carcon999/ABXY-buttons/README.md

# ABXY-buttons

🌐 Select Language / 言語を選択してください

- 🇯🇵 [日本語 (Japanese)](README.ja.md)
- 🇺🇸 [English](README.en.md)

Watch the video (https://www.youtube.com/watch?v=ZZdw2gTKmag)
