carcon999/ABXY-buttons/document/MY_DEVELOPMENT_ENVIRONMENT.en.md

## Personal Development Environment

This section outlines the development environment I used for this project.  
I am grateful for the many free tools that made this possible.

- Windows 11 Pro
- Arduino IDE 2.3.6
- KiCad Version 9.0.3
- FreeCAD 1.0.1
- Bambu Lab A1 mini (3D printer)

[Back](../README.en.md)
