carcon999/ABXY-buttons/document/MY_DEVELOPMENT_ENVIRONMENT.ja.md

## 個人開発環境
私がこのプロジェクトで使った開発環境の情報を示します。多くの無償で利用できるツールを提供してもらえたことに感謝しています。

- Widows11 Pro
- Arduino IDE 2.3.6
- KiCad Version 9.0.3
- FreeCAD 1.0.1
- Bambu Lab A1 mini (3D Printer)

[戻る](../README.ja.md)
