carcon999/ABXY-buttons/document/Q_AND_A.ja.md

## ノウハウ
問題が発生した場合の解決方法などを整理しておきます。

### ■接続・切断が繰り返される（赤・緑が交互に点滅する）
ペアリングした相手との接続情報が一方で失われて、不一致な状態が発生していると思われます。Windows/Mac/iPhone/Android側で登録されているデバイスを一度削除し、再度ペアリングを実施してみてください。

### ■ボタンを押してもLEDが赤に点灯しない。
久しぶりのご利用の場合は、電池が充電されてない可能性があるので、5分程度充電して反応を確認してください。
電池に残量がある場合には、一度カバーを開けて、Resetボタンを押して（ON->OFF）ください。

### ■シリアルポートが認識されない。
Bootボタンを押しながらResetボタンを押して（ON->OFF）ください。BootLoaderモードで起動することで、必ずシリアルポートが有効になります。

### ■特定のA,B,X,Yボタンが押しても反応しない。
ほこりやゴミが導電ゴムに付着している可能性があります。一度分解して接点部分を掃除してみてください。

### ■シリアルポートが認識されない。（その２）
別なType-Cケーブルでお試しください。充電用ではない、通信が可能なケーブルでもう一度お試しください。

[戻る](../README.ja.md)
