carcon999/ABXY-buttons/hardware/boaud_image.png

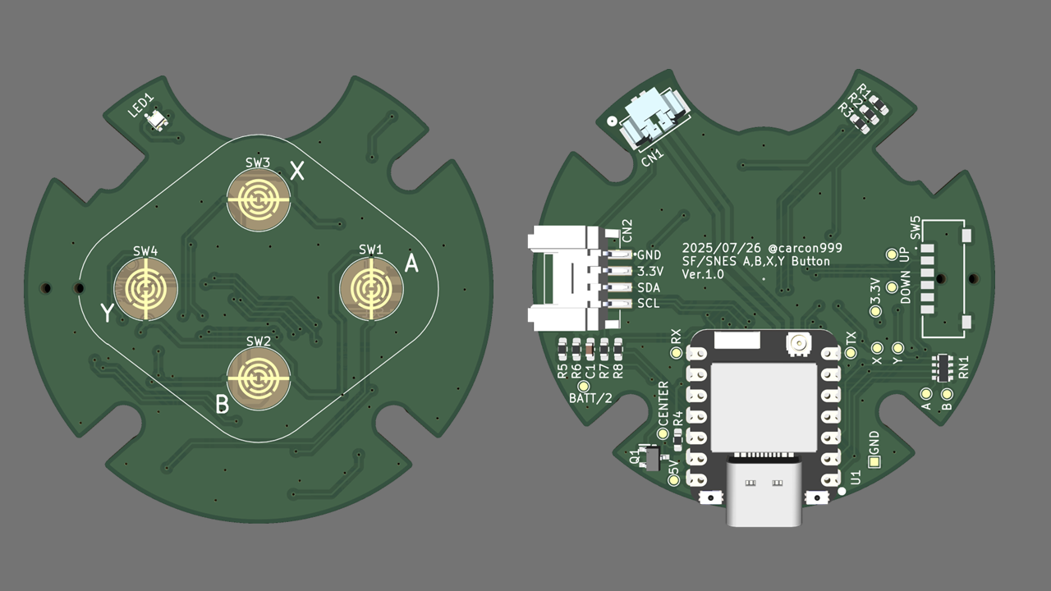
hardware/boaud_image.png
