carcon999/ABXY-buttons/image/change_image.png

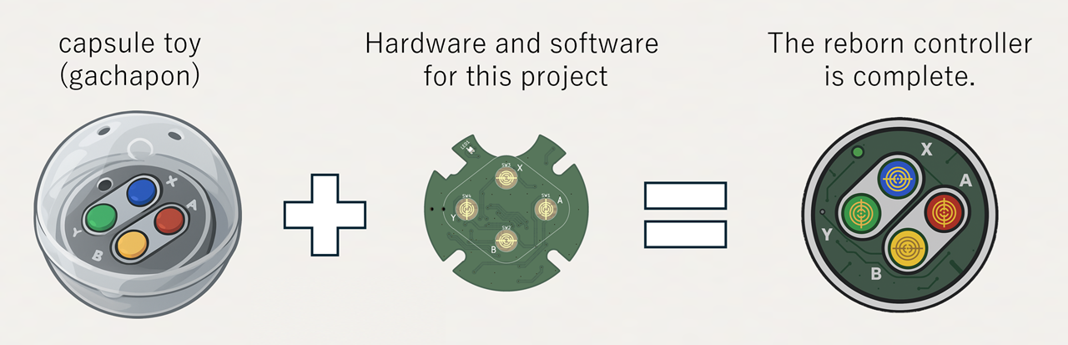
image/change_image.png
