carcon999/ABXY-buttons/image/IMG_1977.jpg

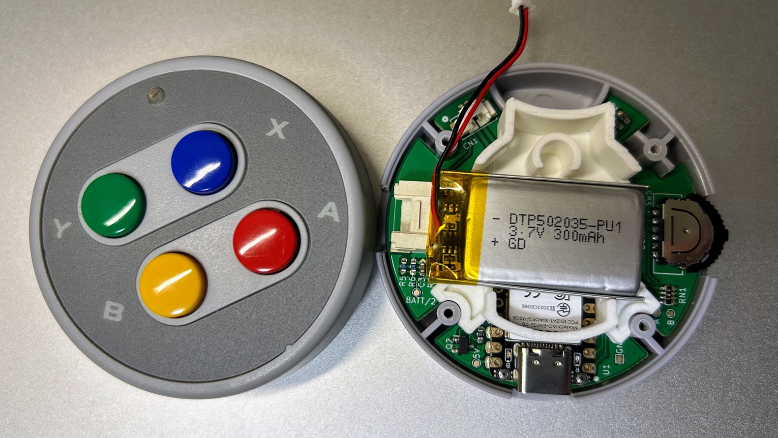
image/IMG_1977.jpg
