carcon999/ABXY-buttons/image/IMG_1980.jpg

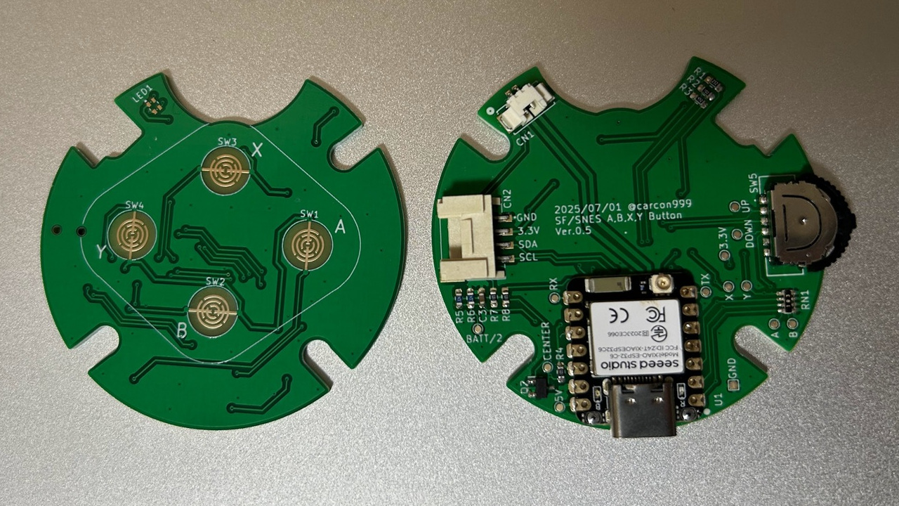
image/IMG_1980.jpg
