carcon999/ABXY-buttons/image/play_image.png

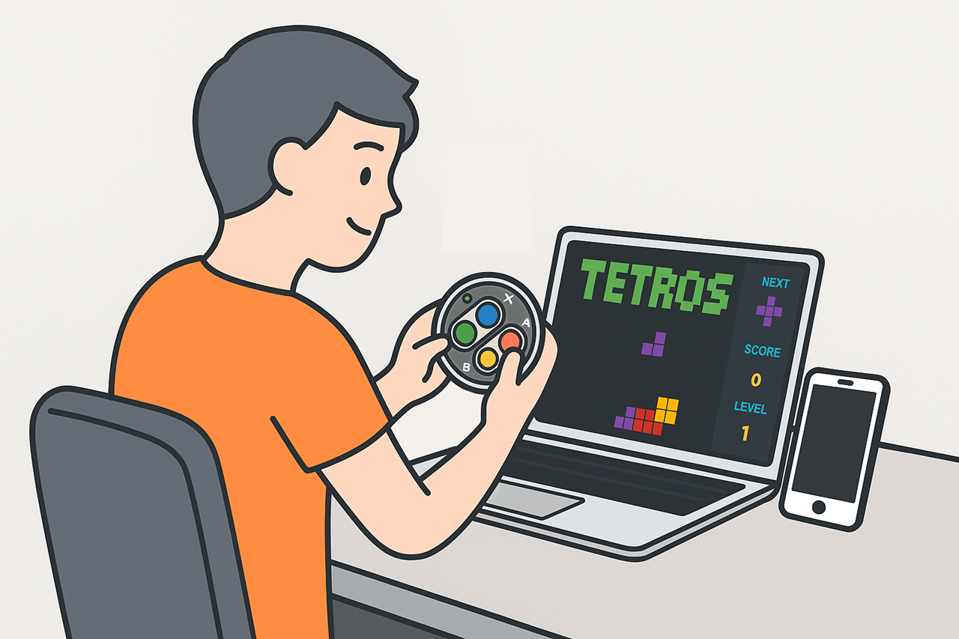
image/play_image.png
