carcon999/ABXY-buttons/hardware/BOM_list.pdf

SF_SNES_ABXY_BUTTON

Reference | Qty | Value | Datasheet
C1 | 1 | 0.1u(1608) | ~
CN1 | 1 | Molex_0532610271 | https://www.molex.com/content/dam/molex/molex-dot-com/products/automated/en-us/salesdrawingpdf/532/53261/532610271_sd.pdf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
CN2 | 1 | Grove-90D | https://files.seeedstudio.com/products/114020164/res/Grove%20Female%20Header%20-%20SMD-4P-2.0mm-90D%20Datasheet.pdf
LED1 | 1 | OSTB0603C1C-A | https://datasheet.octopart.com/OSTB0603C1C-A-OptoSupply-datasheet-26746446.pdf
Q1 | 1 | 2SC4713K | https://fscdn.rohm.com/en/products/databook/datasheet/discrete/transistor/bipolar/2sc4713kt146r-e.pdf
R1 | 1 | 2.7k(1608) | ~
R2 | 1 | 1k(1608) | ~
R3 | 1 | 4.7k(1608) | ~
R4,R7,R8 | 3 | 1M(1608) | ~
R5,R6 | 2 | RK73G1JTTD2203D(1608) | https://www.koaglobal.com/-/media/Files/KOA_Global/EN/product/commonpdf/rk73g.pdf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
RN1 | 1 | TSN3BTJ103V | https://www.tateyama.jp/dt/product/p03/doc/P35-36.pdf
SW5 | 1 | TMHU28 | https://akizukidenshi.com/goodsaffix/TMHU28_20180820.pdf
U1 | 1 | XIAO-ESP32-C6-SMD | https://wiki.seeedstudio.com/xiao_esp32c6_getting_started/
BATT | 1 | 300mAh | https://www.marutsu.co.jp/contents/shop/marutsu/datasheet/datapower_DTP502035-PU1.pdf
