carcon999/ABXY-buttons/3d-model/LED-3mmPoint.stl

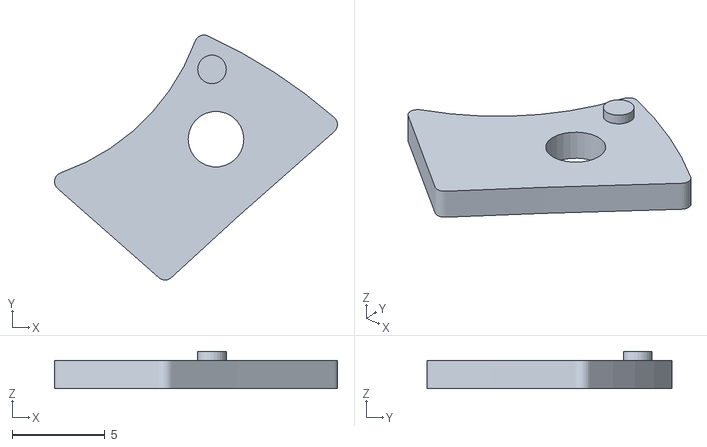
[picture p7: CAD file, 2025-08-10]
3d-model/LED-3mmPoint.stl
15.3 x 13.2 x 2.00
