carcon999/ABXY-buttons/3d-model/ABXY-Inner.stl

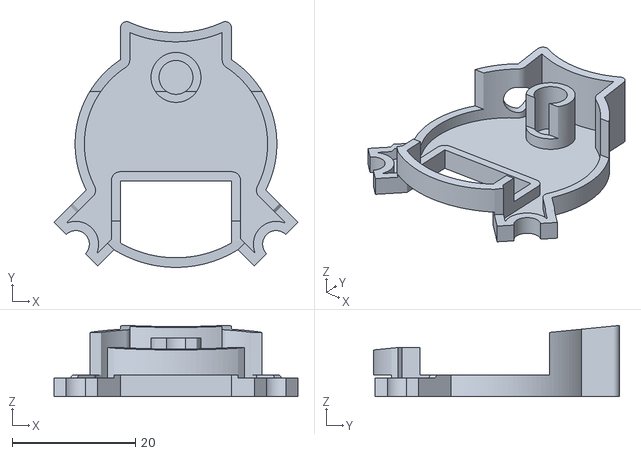
[picture p8: CAD file, 2025-08-10]
3d-model/ABXY-Inner.stl
39.6 x 39.9 x 11.5
