carcon999/ABXY-buttons/image/MAKE/case-top-rubber.jpg

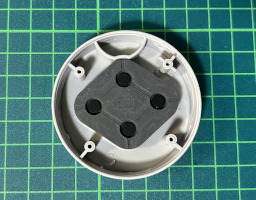
image/MAKE/case-top-rubber.jpg
