carcon999/ABXY-buttons/image/SOFTWARE_BUILD/software.png

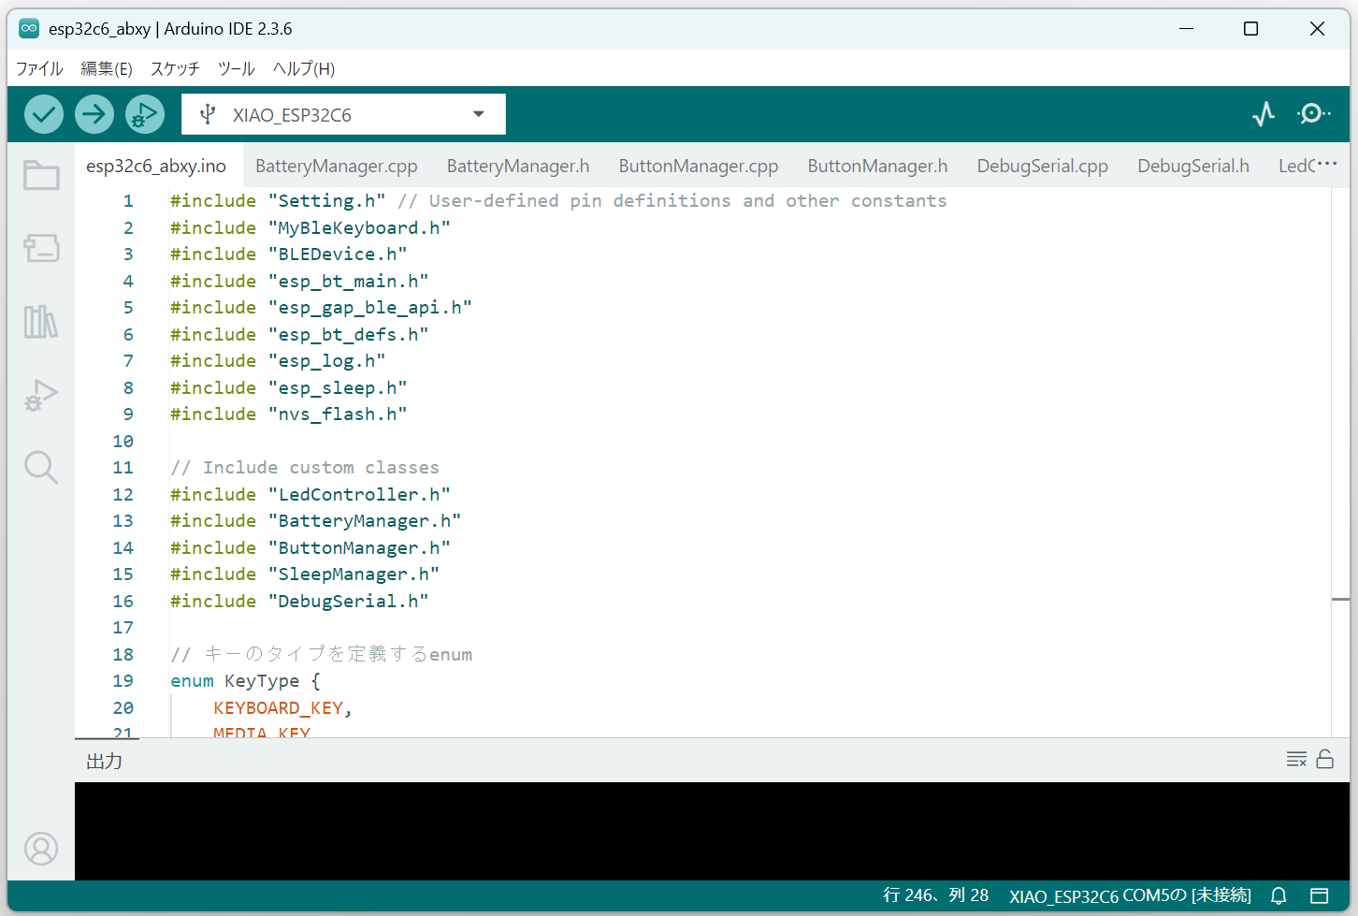
image/SOFTWARE_BUILD/software.png
