carcon999/ABXY-buttons/hardware/SF_SNES_ABXY_BUTTON.pdf

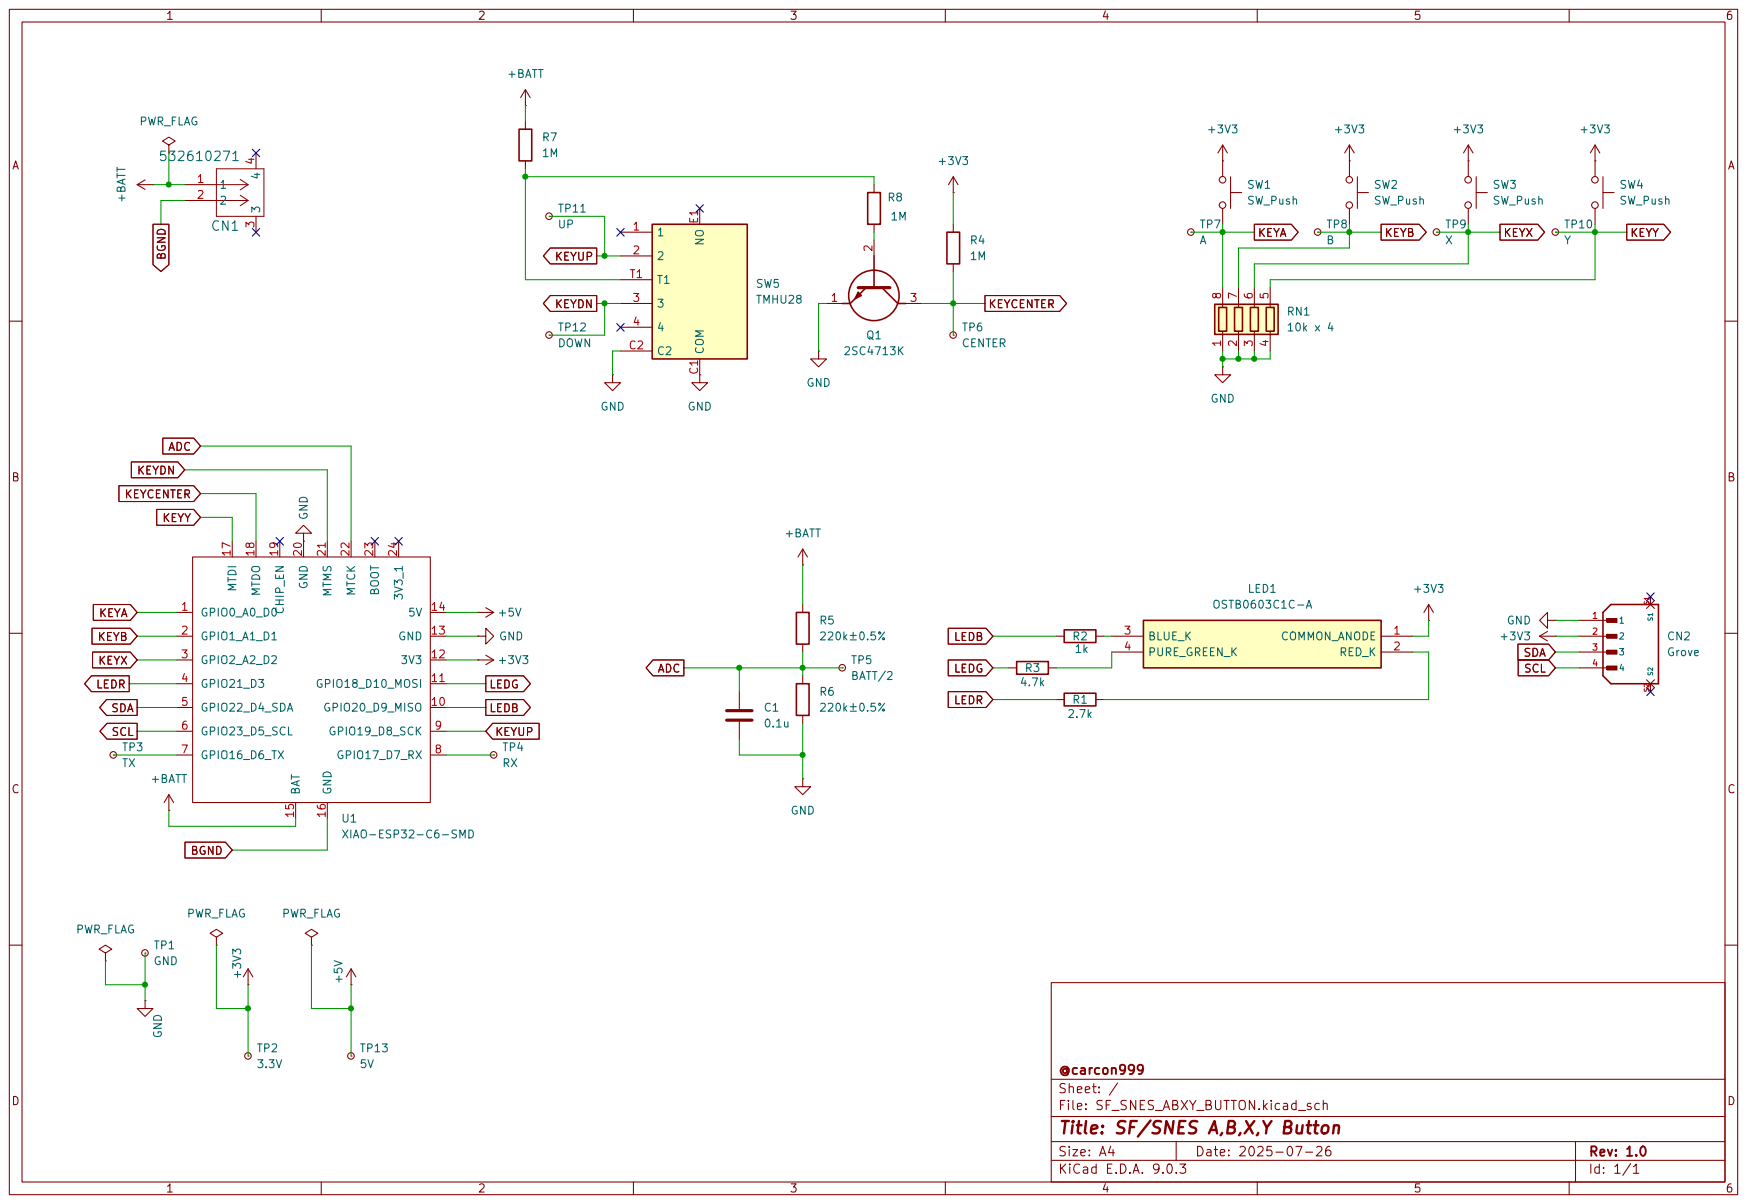
[picture p60: page 1]
